yukiyes336/fall-detection-nexys-a7/README.md

# fall-detection-nexys-a7
FPGA-based fall detection system using MPU6050 and Nexys A7-100T
