yukiyes336/fall-detection-nexys-a7/board/nexys_a7/constraints/top.xdc

set_property -dict { PACKAGE_PIN E3    IOSTANDARD LVCMOS33 } [get_ports { clk }];
create_clock -add -name sys_clk_pin -period 10.00 -waveform {0 5} [get_ports { clk }];
set_property -dict { PACKAGE_PIN C12   IOSTANDARD LVCMOS33 } [get_ports { rst_n }];
set_property -dict { PACKAGE_PIN D4    IOSTANDARD LVCMOS33 } [get_ports { tx }];
set_property -dict { PACKAGE_PIN D14   IOSTANDARD LVCMOS33 } [get_ports { scl }];
set_property -dict { PACKAGE_PIN F16   IOSTANDARD LVCMOS33 } [get_ports { sda }];
